wychlw/RemoSwitch/Hardware/v0.9.0-rc1/BOM-v0.9.0.xlsx

No. | Quantity | Comment | Designator | Footprint | Value | Manufacturer Part | Manufacturer | Supplier Part | Supplier
1 | 8 | 100nF | C36,C41,C42,C45,C46,C84,C85,C86 | C0603 | 100nF
2 | 8 | 100nF | C74,C75,C102,C103,C104,C105,C106,C107 | C0402 | 100nF
3 | 4 | 10uF | C92,C93,C94,C98 | C0603 | 10uF
4 | 3 | 1uF | C96,C97,C99 | C0603 | 1uF
5 | 2 | 20pF | C100,C101 | C0603 | 20pF
6 | 1 | TF PUSH | CARD1 | TF-SMD_TF-PUSH |  | TF PUSH | SHOU HAN(首韩) | C393941 | LCSC
7 | 1 | 2.2uH | L2 | IND-SMD_L2.5-W2.0_MHCHL2520 | 2.2uH | FTC252012S2R2MBCA | cjiang(长江微电) | C5832372 | LCSC
8 | 4 | LED-0603_R | LED11,LED12,LED13,LED15 | LED0603_RED |  | 19-217/R6C-AL1M2VY/3T | EVERLIGHT(台湾亿光) | C72044 | LCSC
9 | 2 | AO3401A | Q2,Q3 | SOT-23_L2.9-W1.3-P1.90-LS2.4-BR |  | AO3401A | AOS | C15127 | LCSC
10 | 1 | 680 | R26 | R0603 | 680
11 | 5 | 1K | R39,R40,R44,R52,R54 | R0603 | 1K
12 | 5 | 10K | R41,R55,R56,R62,R63 | R0603 | 10K
13 | 1 | 22K | R43 | R0603 | 22K
14 | 3 | 5.1K | R57,R58,R59 | R0603 | 5.1K
15 | 1 | NC | R64 | R0603 | NC
16 | 1 | GL3224-OIY04 | U2 | HQFN-32_L5.0-W5.0-P0.50-BL-EP3.0 |  | GL3224-OIY04 | GENESYS(创惟) | C157357 | LCSC
17 | 1 | TS3DV642A0RUAR | U3 | WFQFN-42_L9.0-W3.5-P0.50-BL-EP |  | TS3DV642A0RUAR | TI(德州仪器) | C157482 | LCSC
18 | 2 | ESD7104MUTAG | U23,U24 | DFN-10_L2.5-W1.0-P0.50-BL |  | ESD7104MUTAG | TECH PUBLIC(台舟) | C2987068 | LCSC
19 | 1 | USBLC6-2SC6-ES | U25 | SOT-23-6_L2.9-W1.6-P0.95-LS2.8-BR |  | USBLC6-2SC6-ES | ElecSuper(静芯微) | C5180249 | LCSC
20 | 1 | CH32V203G6U6 | U27 | QFN-28_L4.0-W4.0-P0.40-BL-EP2.7 |  | CH32V203G6U6 | WCH(南京沁恒) | C5142280 | LCSC
21 | 1 | CH217K | U29 | SOT-23-6_L2.9-W1.6-P0.95-LS2.8-BL |  | CH217K | WCH(南京沁恒) | C7462749 | LCSC
22 | 1 | ME6210A33M3G | U30 | SOT-23-3_L3.0-W1.7-P0.95-LS2.9-BR |  | ME6210A33M3G | MICRONE(南京微盟) | C236680 | LCSC
23 | 1 | CH9102X | U31 | TQFN-28_L5.0-W5.0-P0.50-BL-EP2.7 |  | CH9102X | WCH(南京沁恒) | C5187522 | LCSC
24 | 1 | CH634X | U33 | QFN-68_L8.0-W8.0-P0.40-BL-EP6.2 |  | CH634X | WCH(南京沁恒) | C48985831 | LCSC
25 | 1 | W25X20CLUXIG-TR | U34 | USON8_L3.0-W2.0-P0.50-TL-EP |  | W25X20CLUXIG-TR | WINBOND(华邦) | C164121 | LCSC
26 | 1 | USB_ Type-A | USB2 | USB_ Type-A
27 | 1 | TYPE-C 24P QCHT | USB3 | TYPE-C-SMD_TYPE-C-24P-QCHT |  | TYPE-C 24P QCHT | SHOU HAN(首韩) | C456013 | LCSC
28 | 1 | 24MHz | X10 | CRYSTAL-SMD_4P-L3.2-W2.5-BL | 24MHz | X322524MSB4SI | YXC(扬兴科技) | C15643 | LCSC
