wychlw/RemoSwitch/Hardware/v0.8.0-rc2-a/BOM_remo_v0.8.0-rc2-a.csv

No. | Quantity | Comment | Designator | Footprint | Value | Manufacturer Part | Manufacturer | Supplier Part | Supplier | Device | Name | Add into BOM
1 | 26 | 100nF | C1,C2,C3,C4,C5,C6,C7,C8,C9,C10,C13,C14,C15,C18,C20,C21,C23,C24,C26,C29,C30,C31,C35,C36,C37,C38 | C0402 | 100nF |  |  |  |  | CAP_0402 | 100nF | yes
2 | 4 | 10uF | C19,C32,C34,C39 | C0402 | 10uF |  |  |  |  | CAP_0402 | 10uF | yes
3 | 2 | 0.1u | C89,C90 | C0402 |  |  |  |  |  | 0.1u | 0.1u | yes
4 | 2 | 10uF | C91,C92 | C0603 | 10uF |  |  |  |  | CAP_0603 | 10uF | no
5 | 4 | 20pF | C93,C94,C95,C96 | C0402 | 20pF |  |  |  |  | CAP_0603 | 20pF | yes
6 | 1 | TF PUSH | CARD1 | TF-SMD_TF-PUSH |  | TF PUSH | SHOU HAN(首韩) | C393941 | LCSC | TF PUSH | TF PUSH | yes
7 | 1 | HDR-M_2.54_1x3P | H2 | HDR-TH_3P-P2.54-V-M |  |  |  | C2937625 |  | HDR-M_2.54_1x3P |  | no
8 | 1 | HDR-M_2.54_1x2P | H3 | HDR-TH_2P-P2.54-V-M-1 |  |  |  | C124375 |  | HDR-M_2.54_1x2P |  | no
9 | 2 | 2.2uH | L1,L2 | IND-SMD_L2.5-W2.0_MHCHL2520 | 2.2uH | FTC252012S2R2MBCA | cjiang(长江微电) | C5832372 | LCSC | FTC252012S2R2MBCA | 2.2uH | yes
10 | 5 | LED_0603-R | LED5,LED6,LED7,LED8,LED9 | LED_0603 |  |  |  |  |  | LED_0603-R |  | yes
11 | 3 | AO3401A | Q2,Q3,Q4 | SOT-23_L2.9-W1.3-P1.90-LS2.4-BR |  | AO3401A | AOS | C15127 | LCSC | AO3401A_C15127 | AO3401A | yes
12 | 1 | 680 | R1 | R0603 | 680 |  |  |  |  | Res_0603 | 680 | yes
13 | 1 | 68K | R13 | R0603 | 68K |  |  |  |  | Res_0603 | 68K | yes
14 | 1 | 15K | R14 | R0603 | 15K |  |  |  |  | Res_0603 | 15K | yes
15 | 1 | 20.5K | R17 | R0603 | 20.5K |  |  |  |  | Res_0603 | 20.5K | yes
16 | 6 | 10K | R18,R19,R20,R29,R30,R31 | R0402 | 10K |  |  |  |  | Res_0402 | 10K | yes
17 | 5 | 1K | R21,R22,R24,R27,R28 | R0402 | 1K |  |  |  |  | Res_0402 | 1K | yes
18 | 1 | 10K | R41 | R0603 | 10K |  |  |  |  | Res_0603 | 10K | yes
19 | 2 | 22K | R42,R43 | R0603 | 22K |  |  |  |  | Res_0603 | 22K | no
20 | 2 | Test-Point | TP1,TP2 | Test-Point-0.5mm |  |  |  |  |  | Test-Point |  | yes
21 | 1 | TF卡插头 | U1 | TF卡封装 |  |  |  |  | HeZo | TF卡插头 | TF卡插头 | no
22 | 1 | TS3DV642A0RUAR | U2 | WFQFN-42_L9.0-W3.5-P0.50-BL-EP |  | TS3DV642A0RUAR | TI(德州仪器) | C157482 | LCSC | TS3DV642A0RUAR | TS3DV642A0RUAR | yes
23 | 1 | GL3224-OIY04 | U3 | HQFN-32_L5.0-W5.0-P0.50-BL-EP3.0 |  | GL3224-OIY04 | GENESYS(创惟) | C157357 | LCSC | GL3224-OIY04 | GL3224-OIY04 | yes
24 | 1 | CH634W6G | U6 | QFN-64_L8.0-W8.0-P0.40-TL-EP6.2 |  | CH634W6G | WCH(南京沁恒) | C45986779 | LCSC | CH634W6G | CH634W6G | yes
25 | 2 | TPD4EUSB30DQAR-N | U7,U10 | DFN-10_L2.5-W1.0-P0.50-BL-A |  | TPD4EUSB30DQAR-N | BORN(伯恩半导体) | C5148477 | LCSC | TPD4EUSB30DQAR-N | TPD4EUSB30DQAR-N | yes
26 | 1 | TPD2EUSB30DRTR-N | U8 | SOT-723_L1.2-W0.8-P0.40-LS1.2-BR |  | TPD2EUSB30DRTR-N | BORN(伯恩半导体) | C6165119 | LCSC | TPD2EUSB30DRTR-N | TPD2EUSB30DRTR-N | yes
27 | 1 | TLV62569DBVR | U9 | SOT-23-5_L3.0-W1.7-P0.95-LS2.8-BR |  | TLV62569DBVR | TI(德州仪器) | C141836 | LCSC | TLV62569DBVR | TLV62569DBVR | yes
28 | 1 | VL160 | U11 | MQFN-28_L4.5-W3.5-P0.40-BL-EP |  | VL160 |  | C2841472 | LCSC | VL160 | VL160 | yes
29 | 1 | CH32V203G6U6 | U27 | QFN-28_L4.0-W4.0-P0.40-BL-EP2.7 |  | CH32V203G6U6 | WCH(南京沁恒) | C5142280 | LCSC | CH32V203G6U6 | CH32V203G6U6 | yes
30 | 2 | CH217K | U28,U29 | SOT-23-6_L2.9-W1.6-P0.95-LS2.8-BL |  | CH217K | WCH(南京沁恒) | C7462749 | LCSC | CH217K | CH217K | no,yes
31 | 1 | CH9102X | U31 | TQFN-28_L5.0-W5.0-P0.50-BL-EP2.7 |  | CH9102X | WCH(南京沁恒) | C5187522 | LCSC | CH9102X_C5187522 | CH9102X | yes
32 | 1 | MC-233J08H93 | USB1 | USB-C-SMD_TYPE-C-31-M-20 |  | MC-233J08H93 | HANBO(汉博) | C3039310 | LCSC | MC-233J08H93 | MC-233J08H93 | yes
33 | 1 | 10.0 QTJ6.3 | USB3 | USB-A-SMD_10.0-QTJ6.3 |  | 10.0 QTJ6.3 | SHOU HAN(首韩) | C404966 | LCSC | 10.0 QTJ6.3 | 10.0 QTJ6.3 | yes
34 | 1 | 25MHz | X6 | OSC-SMD_4P-L2.5-W2.0-BL-1 | 25MHz | OT252025MJBA4SL | YXC(扬兴晶振) | C717683 | LCSC | OT252025MJBA4SL | 25MHz | no
35 | 2 | 24MHz | X7,X8 | CRYSTAL-SMD_4P-L3.2-W2.5-BL | 24MHz | X322524MSB4SI | YXC(扬兴科技) | C15643 | LCSC | X322524MSB4SI | 24MHz | yes
