wychlw/RemoSwitch/Hardware/v0.9.0-rc1/SCH_v0.9.0.pdf

NC

## TF Card

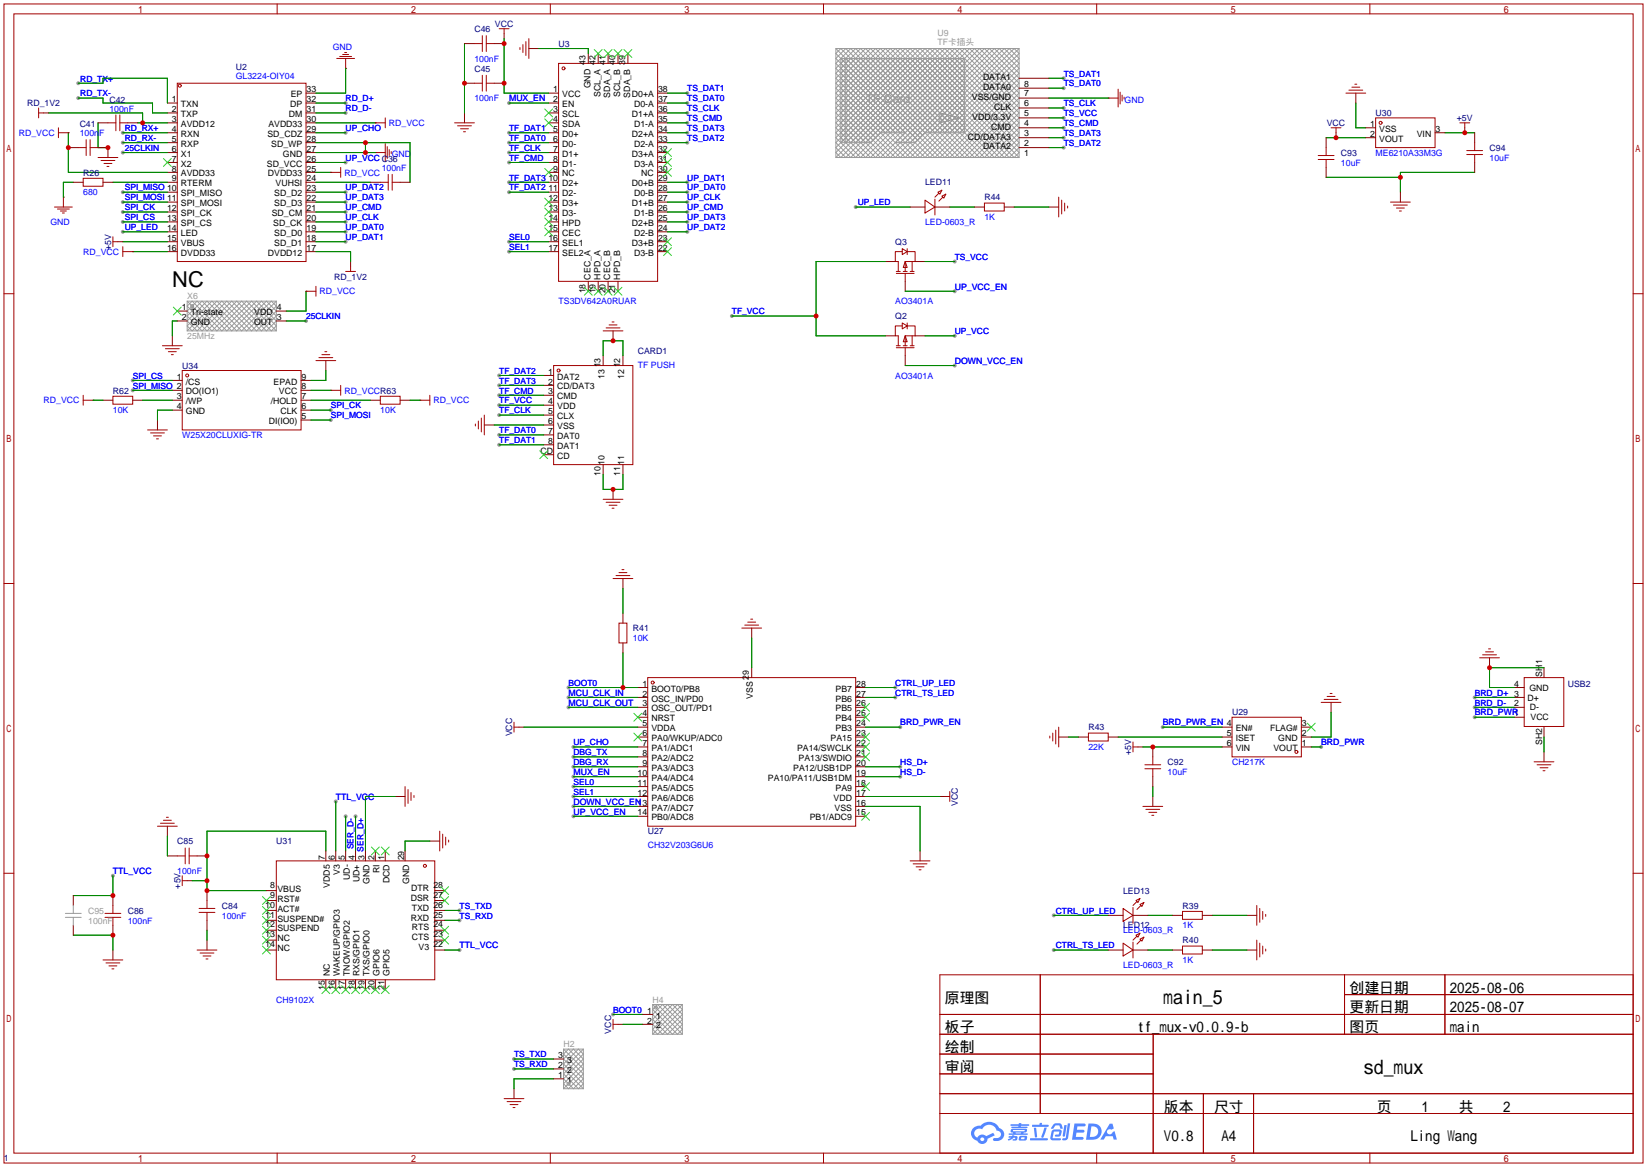
[picture p2: page 1]

原理图 | main_5 | 创建日期 | 2025-08-06

更新日期 | 2025-08-07

板子 | tf_mux-v0.0.9-b | 图页 | main
绘制 | | sd_mux
审阅

V0.8 | A4 | Ling Wang

GND A12 RX2+ A11 RX2- A10 VBUS A9 SBU1 A8 D- A7 D+ A6 CC1 A5 VBUS A4 TX1- A3 TX1+ A2 GND A1

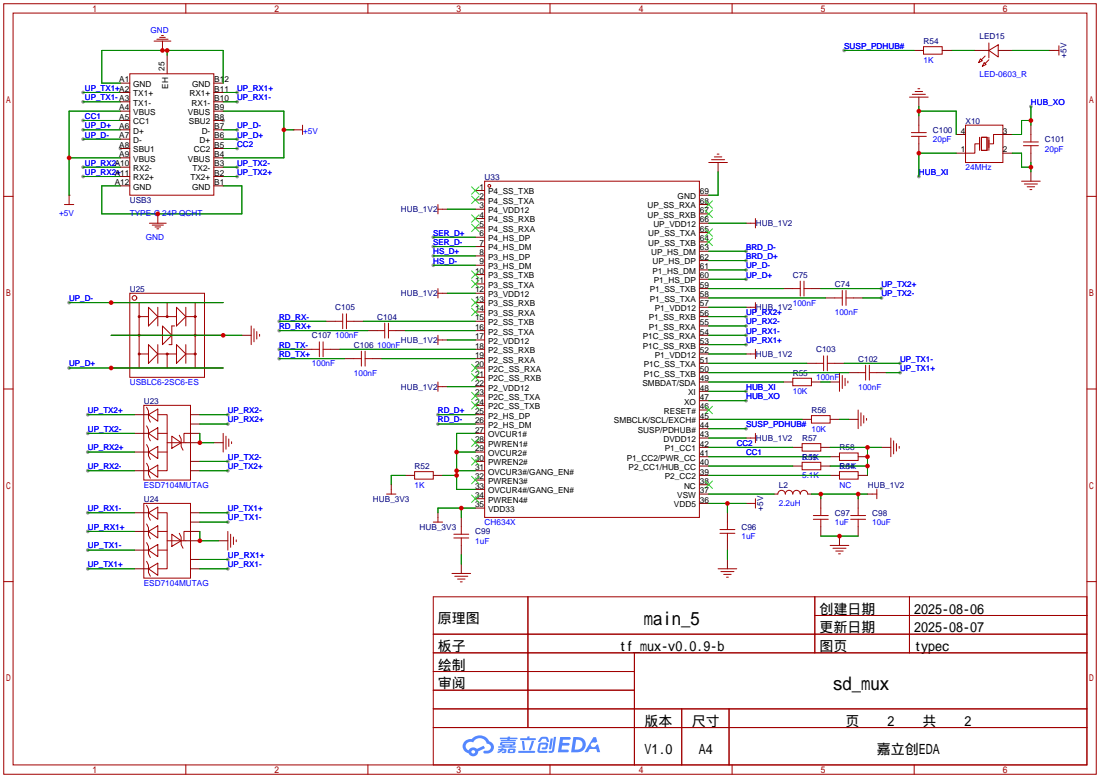
[picture p3: page 2]

原理图 | main_5 | 创建日期 | 2025-08-06

更新日期 | 2025-08-07

板子 | tf_mux-v0.0.9-b | 图页 | typec
绘制 | | sd_mux
审阅

V1.0 | A4 | 嘉立创EDA
