wychlw/RemoSwitch/Hardware/v0.8.0-wip/SCH_remo_v0.8.0.pdf

NC

## TF Card

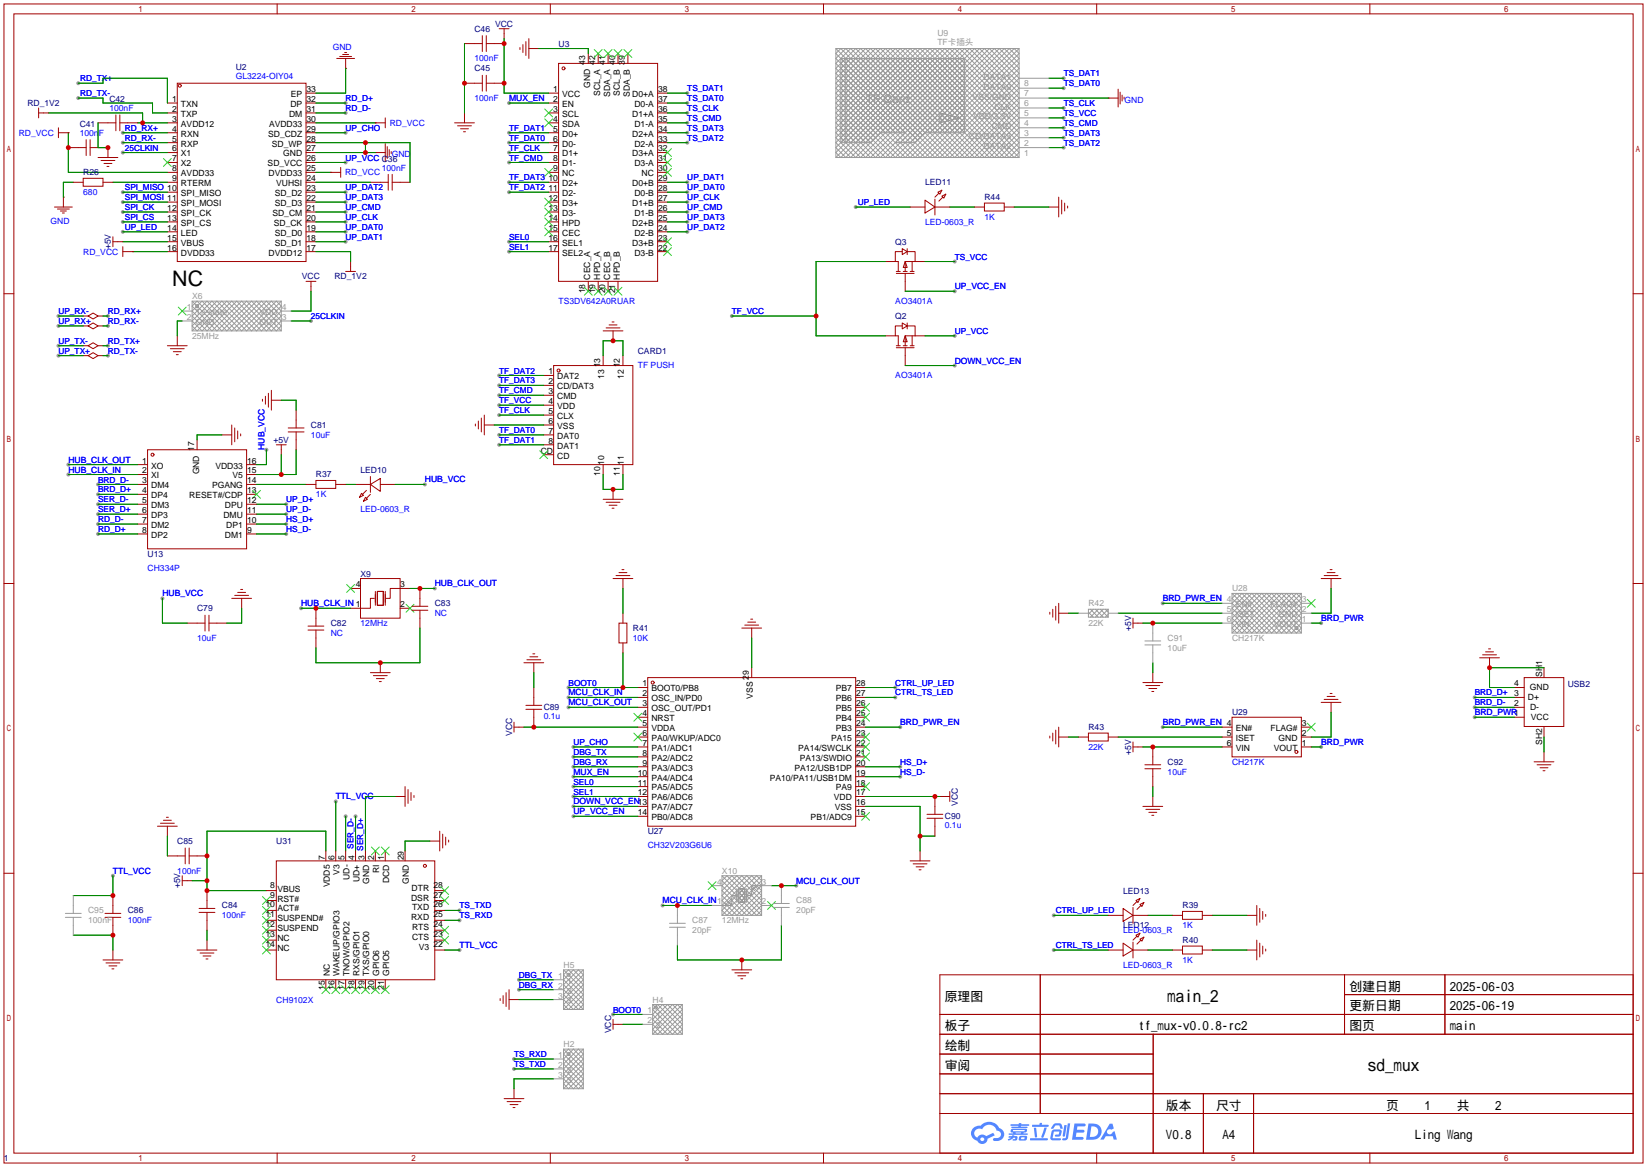
[picture p4: page 1]

原理图 | main_2 | 创建日期 | 2025-06-03

更新日期 | 2025-06-19

板子 | tf_mux-v0.0.8-rc2 | 图页 | main
绘制 | | sd_mux
审阅

V0.8 | A4 | Ling Wang

GND A12 RX2+ A11 RX2- A10 VBUS A9 SBU1 A8 D- A7 D+ A6 CC1 A5 VBUS A4 TX1- A3 TX1+ A2 GND A1

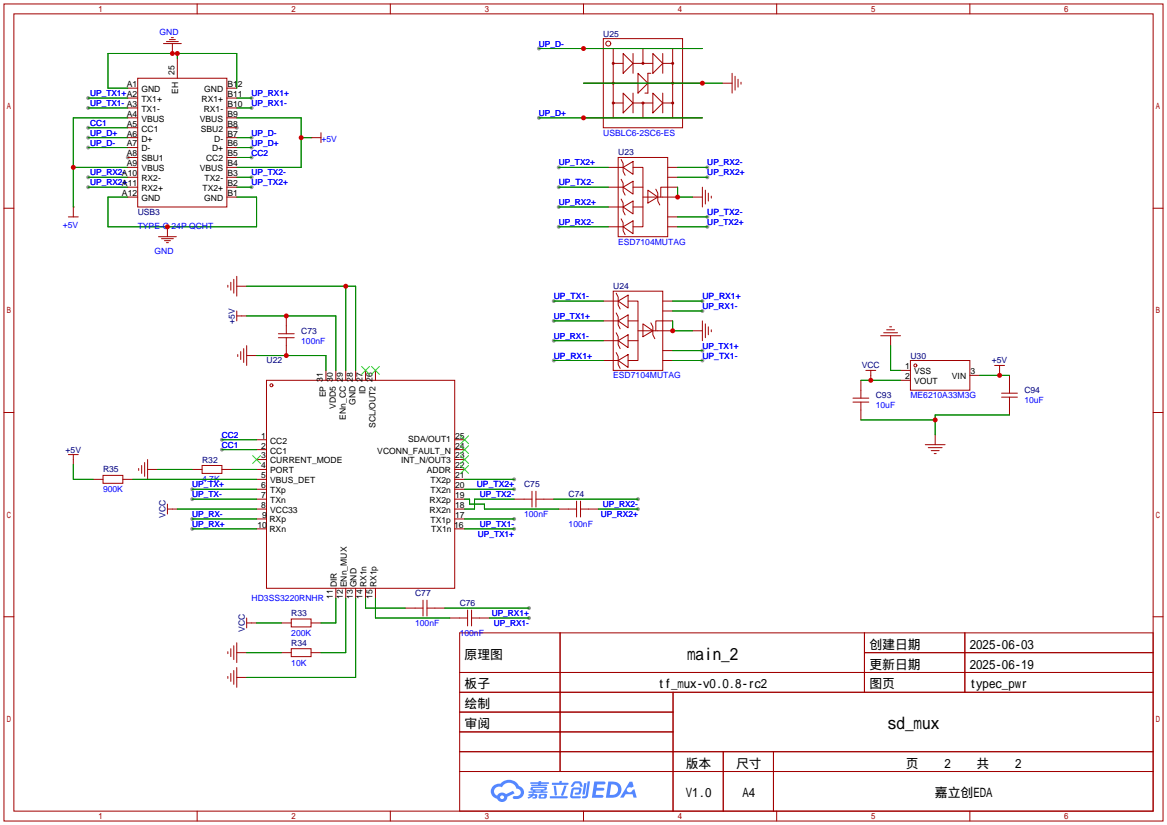
[picture p5: page 2]

原理图 | main_2 | 创建日期 | 2025-06-03

更新日期 | 2025-06-19

板子 | tf_mux-v0.0.8-rc2 | 图页 | typec_pwr
绘制 | | sd_mux
审阅

V1.0 | A4 | 嘉立创EDA
