wychlw/RemoSwitch/Hardware/v0.8.0-rc2-a/SCH_remo_v0.8.0-rc2-a.pdf

## TF Card

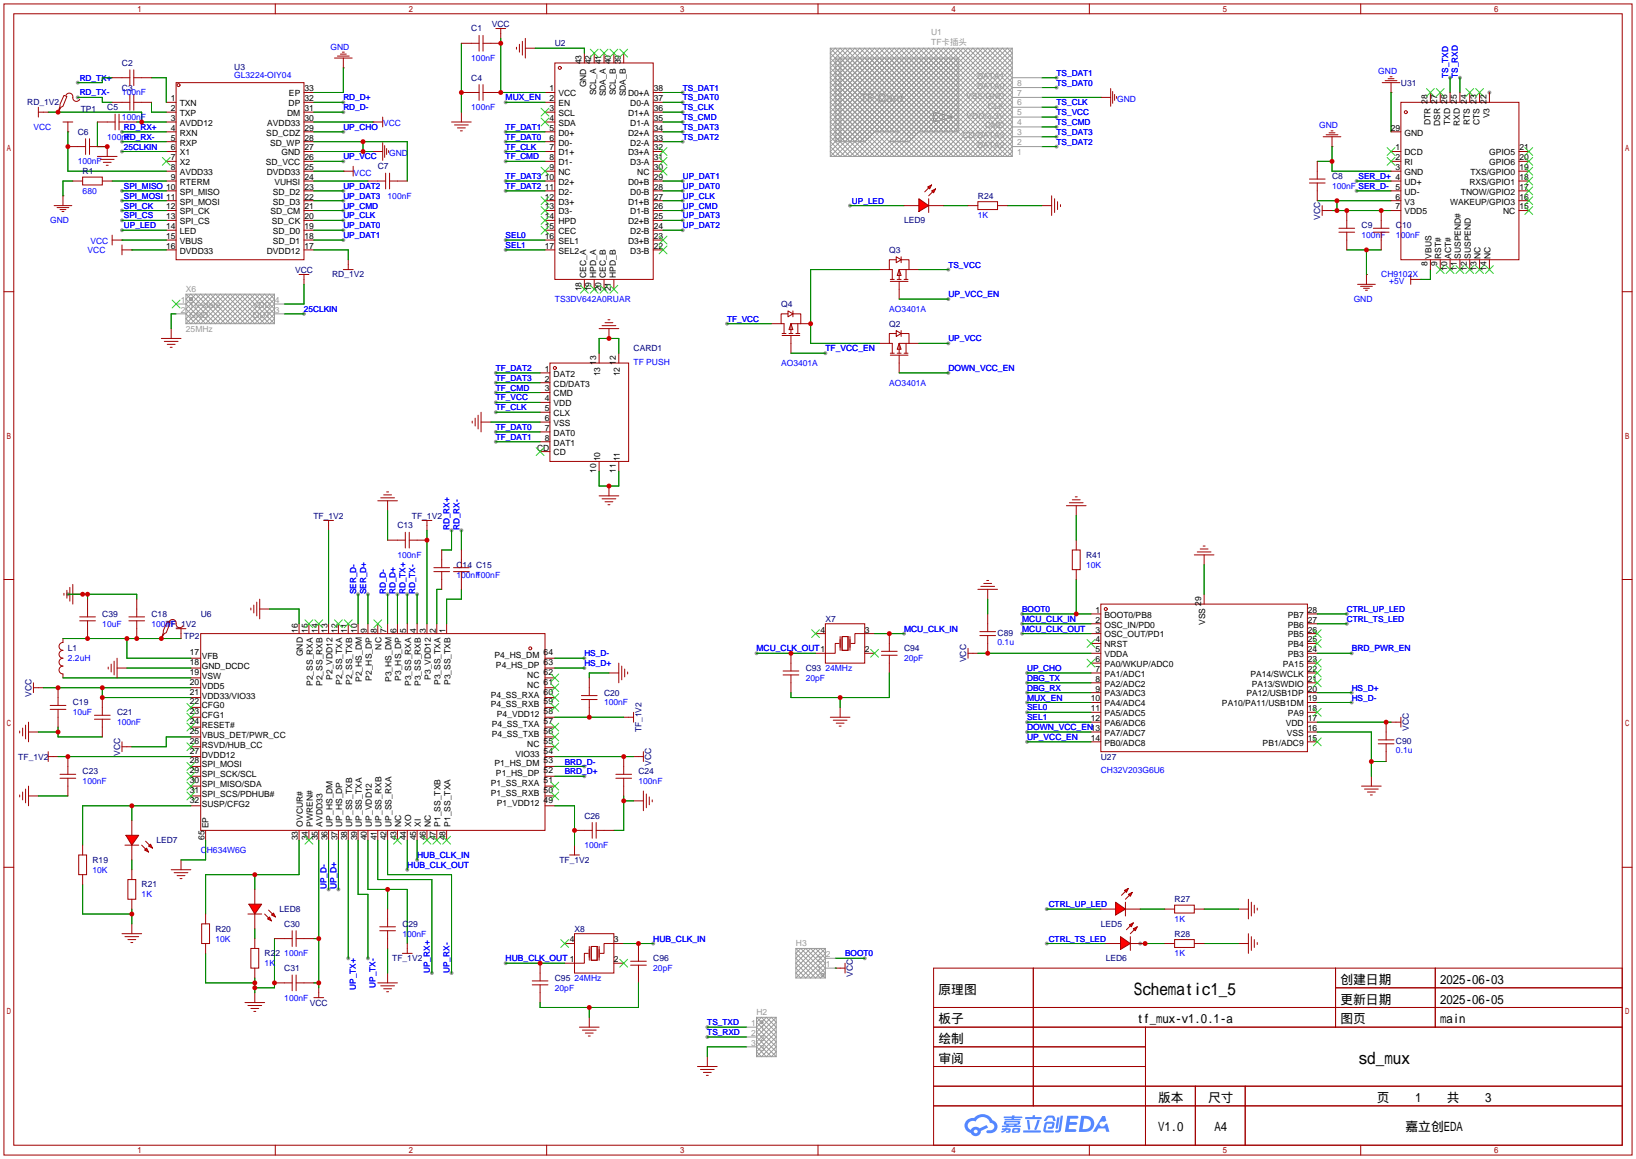
[picture p6: page 1]

原理图 | Schematic1_5 | 创建日期 | 2025-06-03

更新日期 | 2025-06-05

板子 | tf_mux-v1.0.1-a | 图页 | main
绘制 | | sd_mux
审阅

V1.0 | A4 | 嘉立创EDA

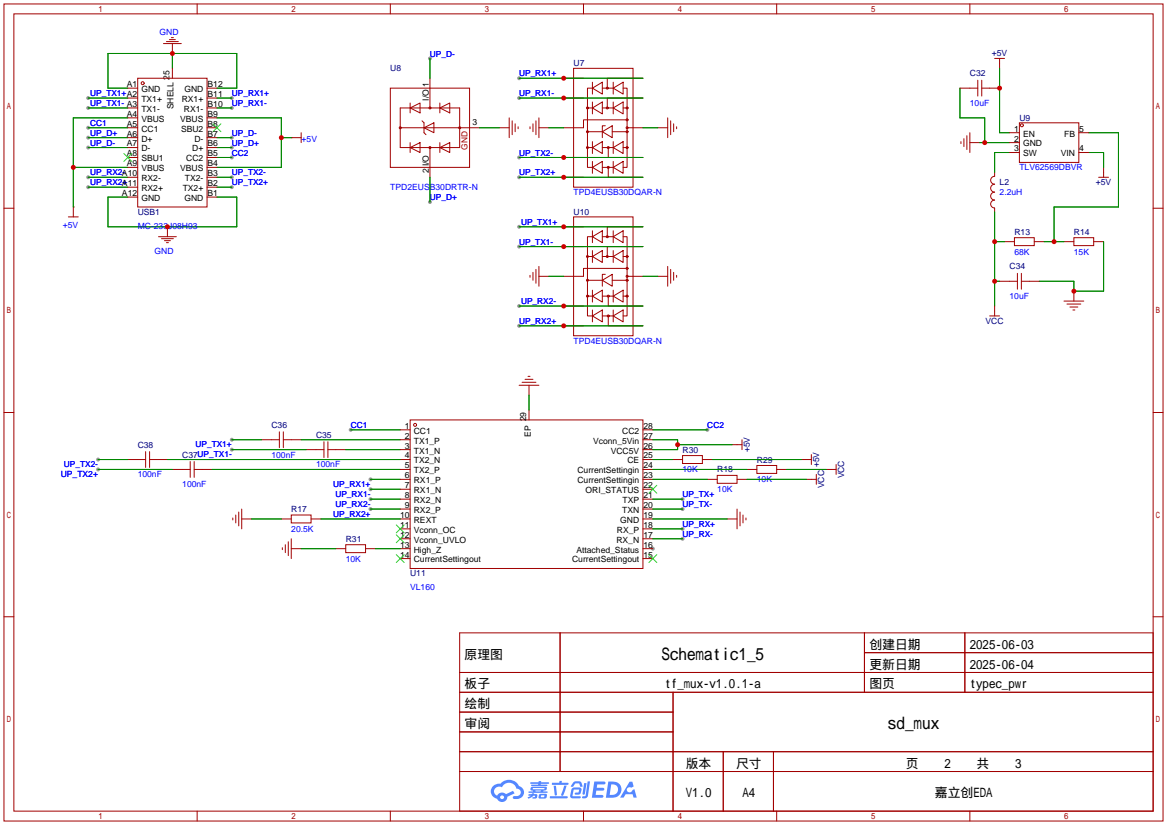
[picture p7: page 2]

原理图 | Schematic1_5 | 创建日期 | 2025-06-03

更新日期 | 2025-06-04

板子 | tf_mux-v1.0.1-a | 图页 | typec_pwr
绘制 | | sd_mux
审阅

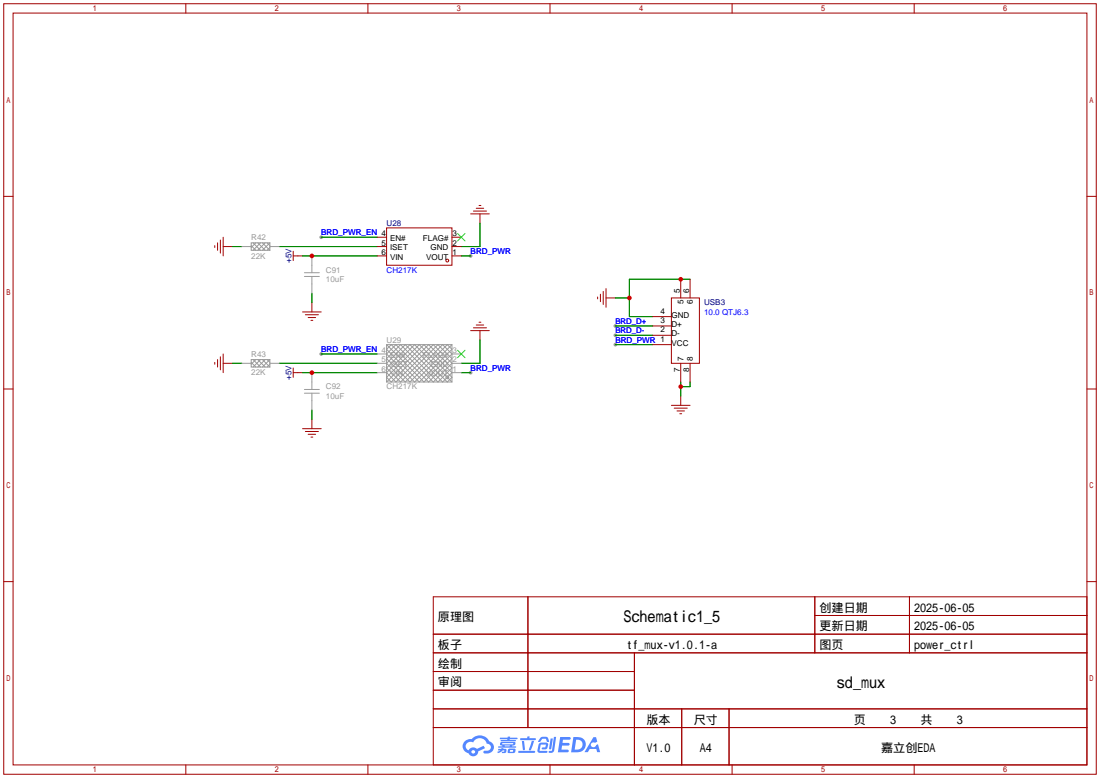
[picture p8: page 3]

原理图 | Schematic1_5 | 创建日期 | 2025-06-05

更新日期 | 2025-06-05

板子 | tf_mux-v1.0.1-a | 图页 | power_ctrl
绘制 | | sd_mux
审阅
