wychlw/RemoSwitch/Hardware/v0.8.0-rc1/SCH_TF_MUX_v0.8.0-rc1.pdf

## TF Card

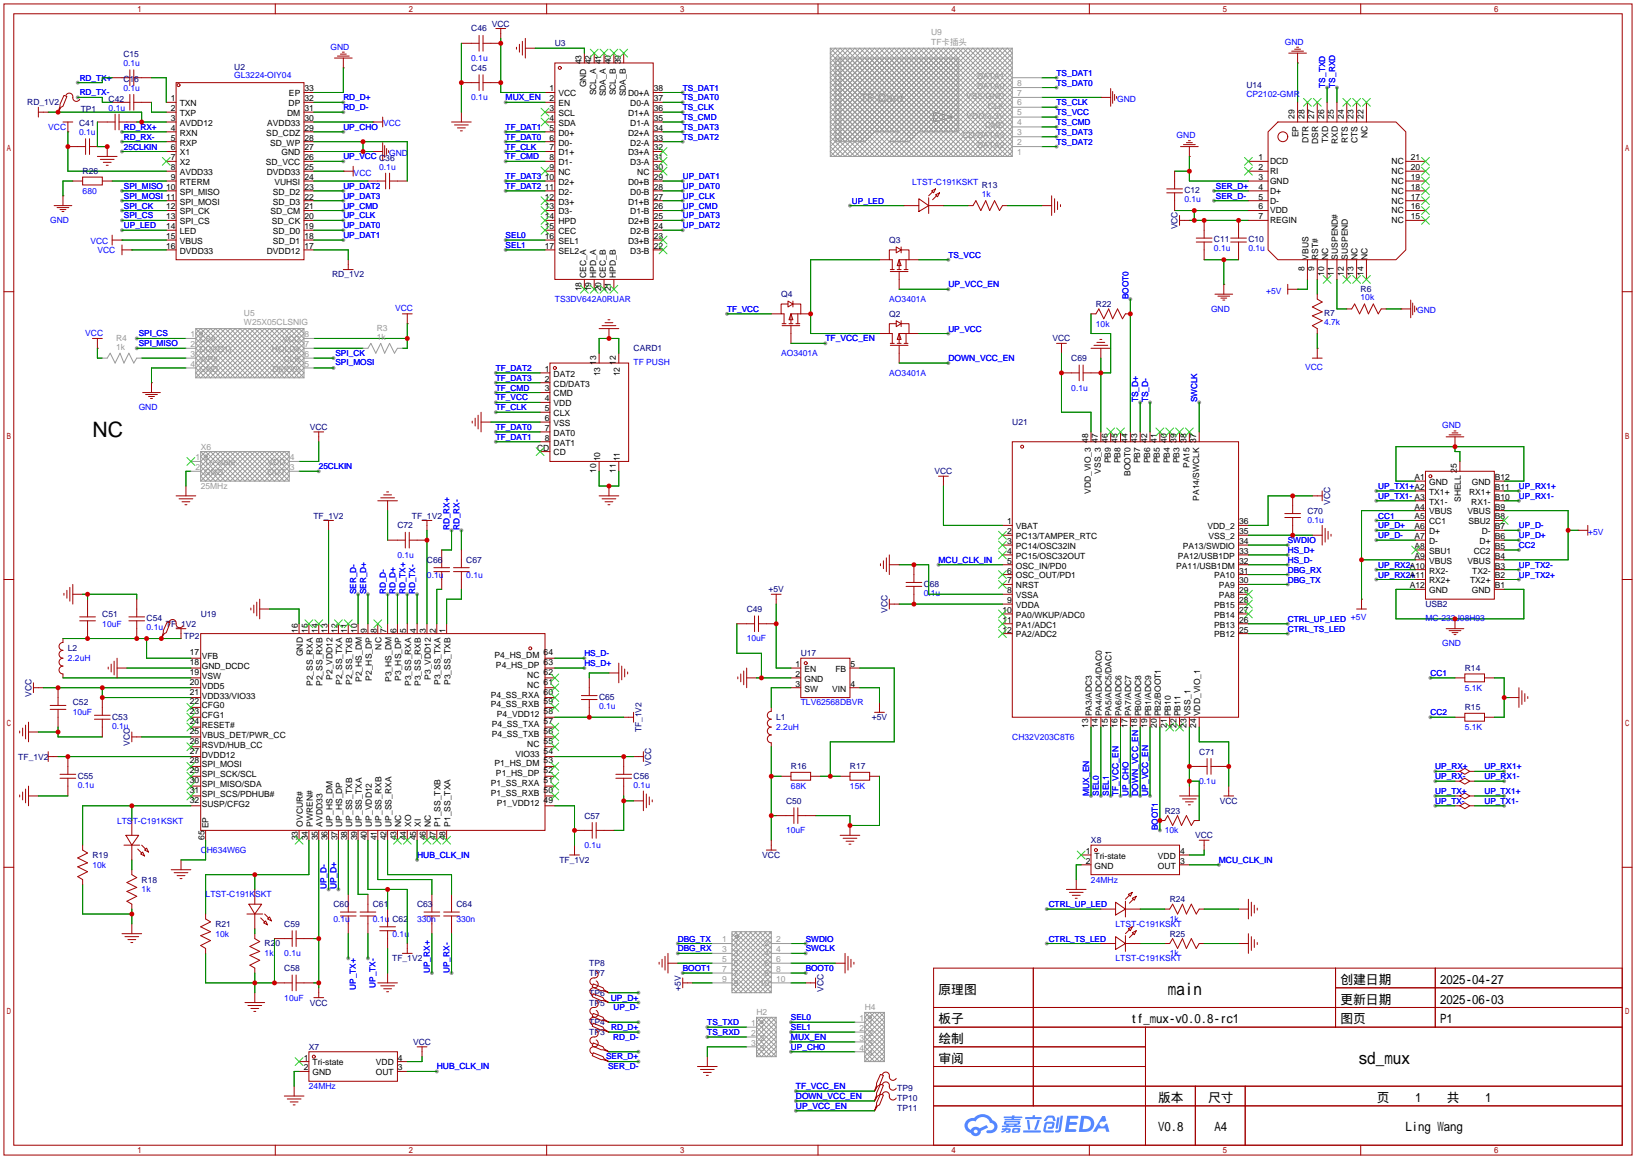
[picture p9: page 1]

NC 22 CTS 23 RTS 24 RXD 25 TXD 26 DSR 27 DTR 28 EP 29

原理图 | main | 创建日期 | 2025-04-27

更新日期 | 2025-06-03

板子 | tf_mux-v0.0.8-rc1 | 图页 | P1
绘制 | | sd_mux
审阅

V0.8 | A4 | Ling Wang
