wychlw/RemoSwitch/(list of files, drawings)

Other design files:
Hardware/v0.8.0-rc1/TF_MUX_v0.8.0-rc.epro
Hardware/v0.8.0-rc2-a/remo-v0.8.0-rc2-a.epro
Hardware/v0.9.0-rc1/v0.9.0.epro
