wychlw/RemoSwitch/Firmware/include/board.h

#ifndef BOARD_H_
#define BOARD_H_

#include "ch32v20x.h"

#ifdef __cplusplus
extern "C" {
#endif

#if defined(CH32V203C8T6)

#warning "Using CH32V203C8T6 board configuration"

#define BLINK_PORT          GPIOA
#define BLINK_PIN           GPIO_Pin_15

#define MUX_EN_PORT         GPIOA
#define MUX_EN_PIN          GPIO_Pin_3

#define SEL0_PORT           GPIOA
#define SEL0_PIN            GPIO_Pin_4

#define SEL1_PORT           GPIOA
#define SEL1_PIN            GPIO_Pin_5

#define UP_CHO_PORT         GPIOA
#define UP_CHO_PIN          GPIO_Pin_7

#define SD_HOST_LED_PORT    GPIOB
#define SD_HOST_LED_PIN     GPIO_Pin_13

#define SD_TS_LED_PORT      GPIOB
#define SD_TS_LED_PIN       GPIO_Pin_12

#define HOST_UART_DEV       USART1
#define HOST_UART_TX_PIN    GPIO_Pin_9
#define HOST_UART_RX_PIN    GPIO_Pin_10

#define TF_VCC_EN_PORT      GPIOA
#define TF_VCC_EN_PIN       GPIO_Pin_6

#define DOWN_VCC_EN_PORT    GPIOB
#define DOWN_VCC_EN_PIN     GPIO_Pin_0

#define UP_VCC_EN_PORT      GPIOB
#define UP_VCC_EN_PIN       GPIO_Pin_1

#define BRD_PWR_EN_PORT     GPIOB
#define BRD_PWR_EN_PIN      GPIO_Pin_3

#define TickMS_TIM          TIM4

#endif

#if defined(CH32V203G6U6)

#warning "Using CH32V203G6U6 board configuration"

#define BLINK_PORT          GPIOA
#define BLINK_PIN           GPIO_Pin_15

#define MUX_EN_PORT         GPIOA
#define MUX_EN_PIN          GPIO_Pin_4

#define SEL0_PORT           GPIOA
#define SEL0_PIN            GPIO_Pin_5

#define SEL1_PORT           GPIOA
#define SEL1_PIN            GPIO_Pin_6

#define UP_CHO_PORT         GPIOA
#define UP_CHO_PIN          GPIO_Pin_1

#define SD_HOST_LED_PORT    GPIOB
#define SD_HOST_LED_PIN     GPIO_Pin_7

#define SD_TS_LED_PORT      GPIOB
#define SD_TS_LED_PIN       GPIO_Pin_6

#define HOST_UART_DEV       USART2
#define HOST_UART_TX_PIN    GPIO_Pin_2
#define HOST_UART_RX_PIN    GPIO_Pin_3

#define TF_VCC_EN_PORT      GPIOB
#define TF_VCC_EN_PIN       GPIO_Pin_5

#define DOWN_VCC_EN_PORT    GPIOA
#define DOWN_VCC_EN_PIN     GPIO_Pin_7

#define UP_VCC_EN_PORT      GPIOB
#define UP_VCC_EN_PIN       GPIO_Pin_0

#define BRD_PWR_EN_PORT     GPIOB
#define BRD_PWR_EN_PIN      GPIO_Pin_3

#define TickMS_TIM          TIM4

#endif

// end

#ifdef __cplusplus
}
#endif

#endif
