wychlw/RemoSwitch/Firmware/src/util.c

#include "ch32v20x.h"
#include "debug.h"
#include <stdbool.h>

#include "util.h"
#include "write.h"

uint8_t HSEFrequencyMhz;
#define F1M 1000000
#define CHECK_ERR_COUNT (8)

#define RTC_COUNT_DELAY (100)
#define HSIClock (8000000)
#define PPL2_ENABLE 1
#define HSE_ENABLE 0

#define STclk_div8 0
#define STclk_div1 1

#define CHECK_MODE STclk_div8
static uint8_t value = 0;
static uint8_t HSE_FrequencyCheck(void) {

    uint32_t rtc_val;
    uint32_t tick_val;
    uint32_t HSEFrequency, HSEFrequency_x, RTC_DIV_VAL, RTC_CHANGE_TIMEOUT, RTC_COUNT_MAX_TIMEOUT;
    uint8_t count;
#if defined(CH32V20x_D6)
    if (((*(uint32_t *) 0x40022030) & 0x0F000000) != 0) {
        RTC_DIV_VAL = 128;
    } else {
        RTC_DIV_VAL = 512;
    }

#else
    RTC_DIV_VAL = 512;
#endif

    RTC_CHANGE_TIMEOUT = (HSIClock / F1M) * RTC_DIV_VAL;
    RTC_COUNT_MAX_TIMEOUT = (HSIClock / F1M) * RTC_DIV_VAL * RTC_COUNT_DELAY;

    Delay_Init();
    RCC_APB1PeriphClockCmd(RCC_APB1Periph_PWR | RCC_APB1Periph_BKP, ENABLE);
    PWR_BackupAccessCmd(ENABLE);
    BKP_DeInit();
#if defined(CH32V20x_D8) || defined(CH32V20x_D8W)
    RCC_RTCCLKConfig(RCC_RTCCLKSource_HSE_Div512);
#else

    RCC_RTCCLKConfig(RCC_RTCCLKSource_HSE_Div128);
#endif
    RCC_RTCCLKCmd(ENABLE);
    RTC_WaitForLastTask();
    RTC_WaitForSynchro();
    RTC_WaitForLastTask();
    RTC_EnterConfigMode();
    RTC_SetPrescaler(0);
    RTC_WaitForLastTask();
    RTC_ExitConfigMode();
    while ((RCC->BDCTLR & (1 << 15)) != (1 << 15)) {}
    count = CHECK_ERR_COUNT;
    while (1) {
        SysTick->CTLR = 0;
        SysTick->CNT = 0;
#if (CHECK_MODE == STclk_div1)
        SysTick->CTLR = (1 << 5) | (1 << 2) | (1 << 0);
#elif (CHECK_MODE == STclk_div8)
        SysTick->CTLR = (1 << 5) | (1 << 0);
#endif
        rtc_val = RTC_GetCounter();

        while (rtc_val == RTC_GetCounter()) {
            if (SysTick->CNT > RTC_CHANGE_TIMEOUT) {

                return 0;
            }
        }
        SysTick->CTLR = 0;
        SysTick->CNT = 0;
#if (CHECK_MODE == STclk_div1)
        SysTick->CTLR = (1 << 5) | (1 << 2) | (1 << 0);
#elif (CHECK_MODE == STclk_div8)
        SysTick->CTLR = (1 << 5) | (1 << 0);
#endif
        rtc_val += (RTC_COUNT_DELAY);
        while (rtc_val >= RTC_GetCounter()) {
            if (SysTick->CNT > RTC_COUNT_MAX_TIMEOUT) {
                return 0;
            }
        }
        tick_val = SysTick->CNT;
        SysTick->CTLR = 0;
#if (CHECK_MODE == STclk_div1)
        HSEFrequency = HSIClock / (tick_val / RTC_DIV_VAL) * RTC_COUNT_DELAY;
#elif (CHECK_MODE == STclk_div8)
        HSEFrequency = HSIClock / (tick_val / (RTC_DIV_VAL / 8)) * RTC_COUNT_DELAY;
#endif
        HSEFrequencyMhz = (HSEFrequency + (F1M / 2)) / F1M;


        SysTick->CTLR = 0;
        SysTick->CNT = 0;
#if (CHECK_MODE == STclk_div1)
        SysTick->CTLR = (1 << 5) | (1 << 2) | (1 << 0);
#elif (CHECK_MODE == STclk_div8)
        SysTick->CTLR = (1 << 5) | (1 << 0);
#endif
        rtc_val = RTC_GetCounter();
        while (rtc_val == RTC_GetCounter()) {
            if (SysTick->CNT > RTC_CHANGE_TIMEOUT) {
                return 0;
            }
        }
        SysTick->CTLR = 0;
        SysTick->CNT = 0;
#if (CHECK_MODE == STclk_div1)
        SysTick->CTLR = (1 << 5) | (1 << 2) | (1 << 0);
#elif (CHECK_MODE == STclk_div8)
        SysTick->CTLR = (1 << 5) | (1 << 0);
#endif
        rtc_val += (RTC_COUNT_DELAY);
        while (rtc_val >= RTC_GetCounter()) {
            if (SysTick->CNT > RTC_COUNT_MAX_TIMEOUT) {
                return 0;
            }
        }
        tick_val = SysTick->CNT;
        SysTick->CTLR = 0;
#if (CHECK_MODE == STclk_div1)
        HSEFrequency = HSIClock / (tick_val / RTC_DIV_VAL) * RTC_COUNT_DELAY;
#elif (CHECK_MODE == STclk_div8)
        HSEFrequency = HSIClock / (tick_val / (RTC_DIV_VAL / 8)) * RTC_COUNT_DELAY;
#endif

        HSEFrequency_x = (HSEFrequency + (F1M / 2)) / F1M;

        if (HSEFrequencyMhz == HSEFrequency_x) {
            break;
        }
        if (--count == 0) {
            HSEFrequencyMhz = 253;
            break;
        }
    }
    return HSEFrequencyMhz;
}

static bool SetSysClock(void) {
    __IO uint32_t StartUpCounter = 0, HSEStatus = 0;
    RCC->CTLR |= ((uint32_t) RCC_HSEON);

    /* Wait till HSE is ready and if Time out is reached exit */
    do {
        HSEStatus = RCC->CTLR & RCC_HSERDY;
        StartUpCounter++;
    } while ((HSEStatus == 0) && (StartUpCounter != HSE_STARTUP_TIMEOUT));

    if ((RCC->CTLR & RCC_HSERDY) != RESET) {
        value = HSE_FrequencyCheck();
        HSEStatus = (uint32_t) 0x00;

        if ((value >= 3) && (value <= 25)) {
            HSEStatus = (uint32_t) 0x01;
        }

    } else {
        HSEStatus = (uint32_t) 0x00;
    }

    if (value != 8 && value != 24 && value != 16) {
        HSEStatus = (uint32_t) 0x00;
    }

#if defined(CH32V203C8T6) // This version HSE has error
    HSEStatus = 0;// Use HSI as default clock source
    value = 12;
#endif

    if (HSEStatus == (uint32_t) 0x01) {

        /* HCLK = SYSCLK */
        RCC->CFGR0 |= (uint32_t) RCC_HPRE_DIV1;
        /* PCLK2 = HCLK */
        RCC->CFGR0 |= (uint32_t) RCC_PPRE2_DIV1;
        /* PCLK1 = HCLK */
        RCC->CFGR0 |= (uint32_t) RCC_PPRE1_DIV2;

        RCC->CFGR0 &= (uint32_t) ((uint32_t) ~(RCC_PLLSRC | RCC_PLLXTPRE |
                                               RCC_PLLMULL));

        if (value == 8) {
            RCC->CFGR0 |= (uint32_t) (RCC_PLLSRC_HSE | RCC_PLLXTPRE_HSE | RCC_PLLMULL18);
        } else if (value == 24) {
            RCC->CFGR0 |= (uint32_t) (RCC_PLLSRC_HSE | RCC_PLLXTPRE_HSE_Div2 | RCC_PLLMULL12);
        } else if (value == 16) {
            RCC->CFGR0 |= (uint32_t) (RCC_PLLSRC_HSE | RCC_PLLXTPRE_HSE | RCC_PLLMULL9);
        }

        /* Enable PLL */
        RCC->CTLR |= RCC_PLLON;
        /* Wait till PLL is ready */
        while ((RCC->CTLR & RCC_PLLRDY) == 0) {
        }
        /* Select PLL as system clock source */
        RCC->CFGR0 &= (uint32_t) ((uint32_t) ~(RCC_SW));
        RCC->CFGR0 |= (uint32_t) RCC_SW_PLL;
        /* Wait till PLL is used as system clock source */
        while ((RCC->CFGR0 & (uint32_t) RCC_SWS) != (uint32_t) 0x08) {
        }
    } else {

        EXTEN->EXTEN_CTR |= EXTEN_PLL_HSI_PRE;
        /* HCLK = SYSCLK */
        RCC->CFGR0 |= (uint32_t) RCC_HPRE_DIV1;
        /* PCLK2 = HCLK */
        RCC->CFGR0 |= (uint32_t) RCC_PPRE2_DIV1;
        /* PCLK1 = HCLK */
        RCC->CFGR0 |= (uint32_t) RCC_PPRE1_DIV2;

        RCC->CFGR0 &= (uint32_t) ((uint32_t) ~(RCC_PLLSRC | RCC_PLLXTPRE |
                                               RCC_PLLMULL));

        RCC->CFGR0 |= (uint32_t) (RCC_PLLSRC_HSI_Div2 | RCC_PLLXTPRE_HSE | RCC_PLLMULL18);

        /* Enable PLL */
        RCC->CTLR |= RCC_PLLON;
        /* Wait till PLL is ready */
        while ((RCC->CTLR & RCC_PLLRDY) == 0) {
        }
        /* Select PLL as system clock source */
        RCC->CFGR0 &= (uint32_t) ((uint32_t) ~(RCC_SW));
        RCC->CFGR0 |= (uint32_t) RCC_SW_PLL;
        /* Wait till PLL is used as system clock source */
        while ((RCC->CFGR0 & (uint32_t) RCC_SWS) != (uint32_t) 0x08) {
        }
    }

    return HSEStatus == (uint32_t) 0x01;
}

RCC_ClocksTypeDef clocks;

// return: HSE frequency in MHz
// if error, return 0
uint8_t clock_init(void) {

    bool stat = SetSysClock();

    SystemCoreClockUpdate();

    NVIC_PriorityGroupConfig(NVIC_PriorityGroup_1);
    NVIC_EnableIRQ(SysTicK_IRQn);
    SysTick->CTLR = 0;
    SysTick->SR = 0;
    SysTick->CNT = 0;
    SysTick->CMP = SystemCoreClock / 1000 - 1;
    SysTick->CTLR = 0xF;

    RCC_GetClocksFreq(&clocks);
    return stat ? value : 0;
}

size_t board_get_unique_id(uint8_t id[], size_t max_len) {
    (void) max_len;
    volatile uint32_t *ch32_uuid = ((volatile uint32_t *) 0x1FFFF7E8UL);
    uint32_t *serial_32 = (uint32_t *) (uintptr_t) id;
    serial_32[0] = ch32_uuid[0];
    serial_32[1] = ch32_uuid[1];
    serial_32[2] = ch32_uuid[2];

    return 12;
}


void delay_us(uint32_t us) {
    Delay_Us(us);
}

extern uint32_t system_ticks;
uint32_t board_millis(void) {
    return system_ticks;
}

void watchdog_task(void) {
    IWDG_ReloadCounter();
}

void watchdog_init(void) {
    IWDG_WriteAccessCmd(IWDG_WriteAccess_Enable);
    IWDG_SetPrescaler(IWDG_Prescaler_32);
    IWDG_SetReload(0x500);// about 1s
    IWDG_ReloadCounter();
    IWDG_Enable();
    info("Watchdog init done. Feeds in 1s.\r\n");
}

size_t device_id(void) {
    return (*(__IO u32 *) 0x1FFFF7E8) ^
           (*(__IO u32 *) 0x1FFFF7EC) ^
           (*(__IO u32 *) 0x1FFFF7F0);
}
