wychlw/RemoSwitch/(commit log)

2025-04-29 Hardware: Add v0.0.5-RC1
    [BOM_TF_MUX_TF_MUX v0.0.5-RC1.csv, PickAndPlace_PCB_v0.0.5-RC1.xlsx, TF_MUX.epro]
2025-05-30 Update to v0.8.0
    [BOM_TF_MUX_TF_MUX v0.0.5-RC1.csv, BOM_TF_MUX_v0.8.0-rc1.csv, PickAndPlace_PCB_v0.0.5-RC1.xlsx, PickAndPlace_TF_MUX_v0.8.0-rc1.xlsx, TF_MUX.epro, TF_MUX_v0.8.0-rc.epro]
2025-06-03 Software: Add Watchdog to auto reboot
    [main.c, sd_mux.c, util.c, util.h]
2025-06-09 Feat: Add control for board pwr control
2025-06-09 Device: Add G6U6 version
2025-06-09 Fix: Windows byte order
    [hid_cmds.rs]
2025-06-19 fix: Add the missing newline in status output
    [main.rs]
2025-06-19 Fix: fix board power control
    Bug-reported-by: Yao Zi <ziyao@disroot.org>
    [brd_ctrl.c, main.c, usb.c]
2025-06-19 Rename folder with proper name
    [rp2040-openocd.cfg, wch-riscv.cfg]
2025-06-19 Hardware: Add v0.8.0-rc2-a version
    [BOM_TF_MUX_v0.8.0-rc1.csv, BOM_remo_v0.8.0-rc2-a.csv, PickAndPlace_TF_MUX_v0.8.0-rc1.xlsx, PickAndPlace_remo_v0.8.0-rc2.xlsx, TF_MUX_v0.8.0-rc.epro, remo-v0.8.0-rc2-a.epro]
